AmedeeBulle/TTNMkrWanNode/(threads)

Thread 1 (2020-02-11):

Device not work after first join

thetiana, 2020-02-11:
Hello,

I not gonna make it work. when i upload the code for the first time the device works good for couple of hours. but after i reset it cannot join to the network again, on the ttn console i can see request from device to ttn for join the network but the network never return on this join request.

I think is something related to the values saved in the FRAM.

How i can clean the FRAM chip?

I change the application and the device secrets, but the device send strange packets to the ttn with the old app dev secrets.

AmedeeBulle, 2020-02-11:
If the reset pin (1) is low when it initializes it will re-join and rewrite the data in the FRAM.
[See here](https://github.com/AmedeeBulle/TTNMkrWanNode/blob/19cb1dccbb93923679e98ea289ffd29836501025/TTNMkrWanNode/ttn.cpp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).

Alternatively you can either:
- Write a sketch to fill the FRAM with zeroes
- Change the [magic constant](https://github.com/AmedeeBulle/TTNMkrWanNode/blob/19cb1dccbb93923679e98ea289ffd29836501025/TTNMkrWanNode/fram.h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) to something else, this will force a re-join as well.

thetiana, 2020-02-12:
Actually the ttn not return on join request, and FRAM is full with some strange secrets, which not corresponding non of my applications. And the more strange think is the device is only be reset.

I look the code over and over again and everything seems to be OK in the code.  May be i have some issues with the FRAM chip.

What about the settings in ttn network: the device should be OTAA ot ABP?

Thread 2 (2020-02-11):

Debug not work

thetiana, 2020-02-11:
The debug not work at all

I don't have display, and i leave it commented.
After i replace every D_PRINT with Serial.print and every D_PRINTLN with Serial.spintln the debug is working proper.

Tomorrow i can contribute fixed code.

AmedeeBulle, 2020-02-11:
You shouldn't have to replace anything as  the macros are defined here:

https://github.com/AmedeeBulle/TTNMkrWanNode/blob/19cb1dccbb93923679e98ea289ffd29836501025/TTNMkrWanNode/debug.h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

and the debug variable is setup here:
https://github.com/AmedeeBulle/TTNMkrWanNode/blob/19cb1dccbb93923679e98ea289ffd29836501025/TTNMkrWanNode/debug.cpp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

I am not sure why that doesn't work for you...

thetiana, 2020-02-12:
The same config, but not work.
I already make fork of your project, there I fix serial debug. Those days i will try to fix also display debug and add BMP180 sensor support.

You can see the fork in my account.
