AmedeeBulle/TTNMkrWanNode/TTNMkrWanNode/Sensor.h

/*
  Sensor.h

  Pure virtual class for sensors

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
*/
#pragma once
#include <CayenneLPP.h>

class Sensor
{
  public:
    // Setup sensor
    virtual void setup() = 0;
    // Read data, add payload to lpp at payloadIndex
    virtual void collect(CayenneLPP& lpp, int& payloadIndex) = 0;
};
